dsalunga/KS5-Project/diagrams/start.jpg

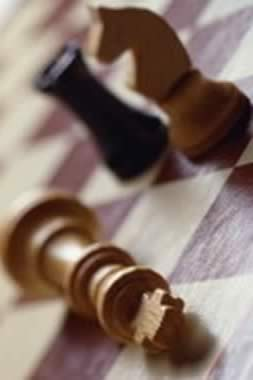
diagrams/start.jpg
