dsalunga/KS5-Project/README.md

# KS5 Project
B. S. Computer Engineering Thesis (Design Project)
