dsalunga/KS5-Project/docs/Chapter VI.pdf

Chapter VI

Conclusion and Recommendations

Conclusion

Given only less than three months and occurrence of inevitable problems

in hardware design, some of the scopes of the study were not realized by the

proponents particularly on the software part. These concerns validation of

moves and capturing chess pieces. Some features such as K-S5’s ability to

accept inputs through Speech Recognition (Voice Command) and K-S5’s ability

to interact with the user through Speech Synthesis were also not realized.

Nevertheless, the proponents concluded that K-S5 can contribute in the

development of human-machine interaction. Because of the accuracy,

consistency and reliability of the machine, the concepts and theories covered by

the study can be adopted or implemented to other applications beneficial to the

different field of the industry. Having the stability and reliability of modern

application platform and programming languages, the functionality of hardware

components are fully maximize.

Recommendations

Due to the limited financial resources, time constraints and experimental

designs failures, the proponents failed to include certain features and

components to make the project a complete success. If further studies are to be

conducted regarding the proponents’ study, the following are some recommendations that the proponents think will improve the performance of the

K-S5:

- Use larger permanent magnet for the chess pieces for easier piece

detection.

- Instead of using the InpOut32.dll to access the parallel port, it is better

develop a device driver for the machine using the Windows Driver

Development Kit.

- Use microcontrollers with more I/O ports and higher memory capacity to

simplify design so that only one microcontroller will be used to control all

the actuators.

- Use better, more uniform chess pieces for weight and height consistency

and proper handling of the machine.

- Include other features such as the ability to accept inputs through Speech

Recognition (Voice Command) and ability to interact with the user through

Speech Synthesis.

- Improve the software part of the K-S5 to fully optimize the validation of

moves and capturing chess pieces.

Bibliography

1. Open Collector Outputs. Acroname. http://www.acroname.com
2. Baker B.C. and Microchip Technology Inc. Circuit Layout Techniques and Tips. http://www.microchip .com/.
3. Boulé M.and Zilic Z. An FPGA Based Move Generator for the Game of Chess. McGill University, Montréal, Canada.
4. Brooks R.A. and Stein L.A. Building Brains for Bodies. Massachusetts Institute of Technology, Artificial Intelligence Laboratory, 545 Technology Square, Cambridge, MA 02139 USA.
5. Brooks R.A. (1990). Elephants Don’t Play Chess. MIT Artificial Intelligence Laboratory, Cambridge, MA 02139, USA.
6. Brooks R.A.(1991).Intelligence without Presentation. MIT Artificial Intelligence Laboratory, 545 Technology Square, Rm. 836, Cambridge, MA 02139.
7. Brooks R.A.. New Approaches to Robotics. Artificial Intelligence Laboratory, Massachusetts Institute of Technology, Cambridge, MA 02139
8. Boulé M.and Zilic Z. An FPGA Based Move Generator for the Game of Chess. McGill University, Montréal, Canada.
9. Buldyzhov V. and Brezhnev K. (2000). Chess Robot KG-2000. Ukrainian State Maritime University (USMTU).
10. Calvin W.H. (1997, May). The Chess Mentality. University of Washington.
11. Davis L. (1998-2005). Logic Threshold Voltage Levels.
12. Dickinson R. and Milano S. (2002, July). Isolated Open Loop Current Sensing Using Hall Effect Technology in an Optimized Magnetic Circuit. Allegro MicroSystems, Inc.
13. Gingrich D. (1999, July). RL Circuit. http://www.phys.ualberta.ca/~gingrich/.

14. Hewis J. (2005). Transistor Circuits. Electronics Club, Kelsey Park School. http://www.kpsec.freeuk.com/.
15. WABOT (200-2004). Humanoid Robotics Institute, Waseda University. http://www.humanoid.rise.waseda.ac.jp/.
16. Deep Blue (1997). IBM Research. http://www.research.ibm.com/deepblue/.
17. Jones, D. W. (1995). Control of Stepping Motors. The University Of IOWA Department Of Computer Science, http://www.cs.uiowa.edu/~jones/.
18. Laidman R. (2001). Stepper Motors and Control: Part IV -Microstepping of Stepper Motors.
19. Mann T. (2003). Chess Engine Communication Protocol. http://www.tim-mann.org/.
20. Microsoft Encarta Encyclopedia 2003 (1992-2002). Microsoft Corporation
21. MSDN Library 2004 (1987-2004). Microsoft Corporation
22. Wabot-2 and Inventor. MSN Encarta. http://encarta.msn.com/.
23. Peacock, C. (1998, February). Interfacing the Standard Parallel Port. http://www.senet.com.au/~cpeacock/.
24. Ryan V. (2002). Light Dependent Resistors. http://www.technologystudent.com/elec1/.
25. Simpson M. (2001-1004). Interface to a 74HC165 Shift Register. Kronos Robotics.
26. Stallings W. (2004). The Complexity of Algorithms.
27. Stork D.G. (1997). HAL, Deep Blue and Kasparov. http://www.research.ibm.com/deepblue/.
28. Bakukang UP MOBOT (2004). UP Department of Electrical & Electronics Engineering Mobile Robotics Laboratory. http://www.upd.edu.ph/~mobot lab/.
