dsalunga/KS5-Project/docs/appendices/diagrams.pdf

Appendix D
Main Circuit PCB Layout

Appendix H
Main Board Sensor-A PCB Layout

Appendix J
Side Board Sensor PCB Layout

Appendix I
Main Board Sensor-B PCB Layout

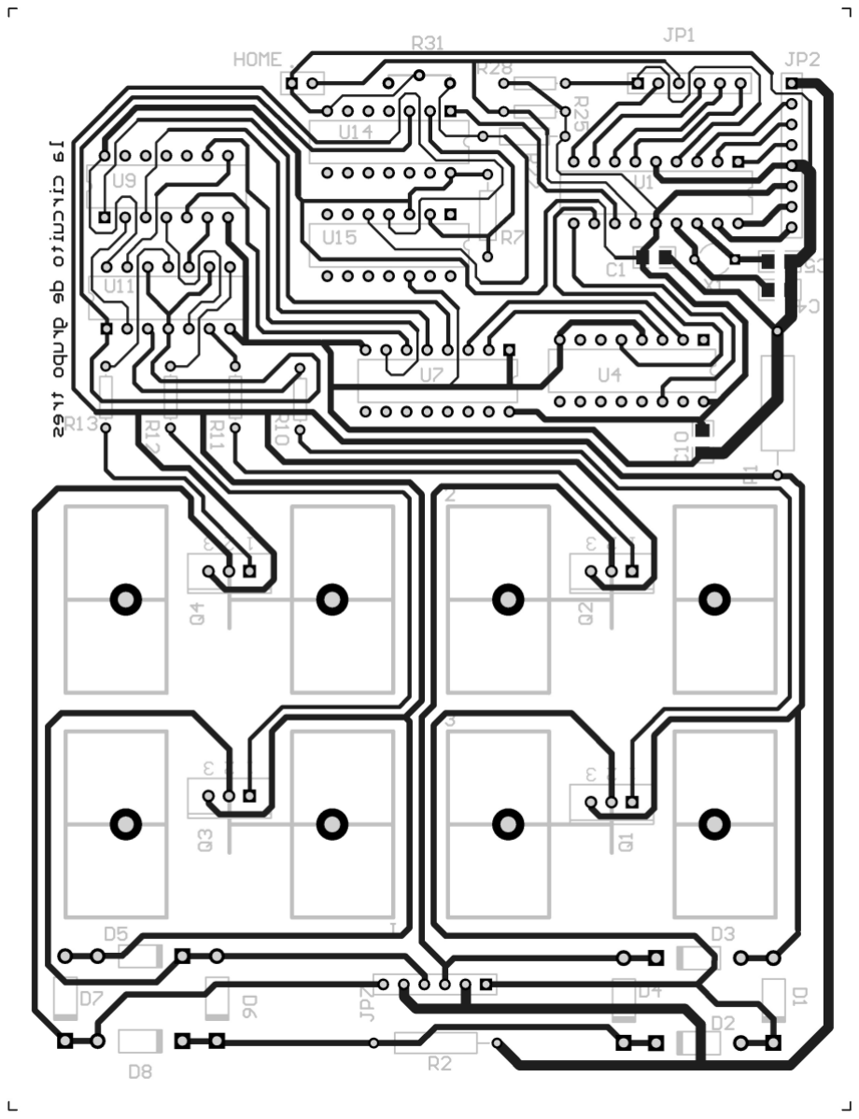
[picture p17: figure]

Appendix E

X-Axis Controller PCB Layout

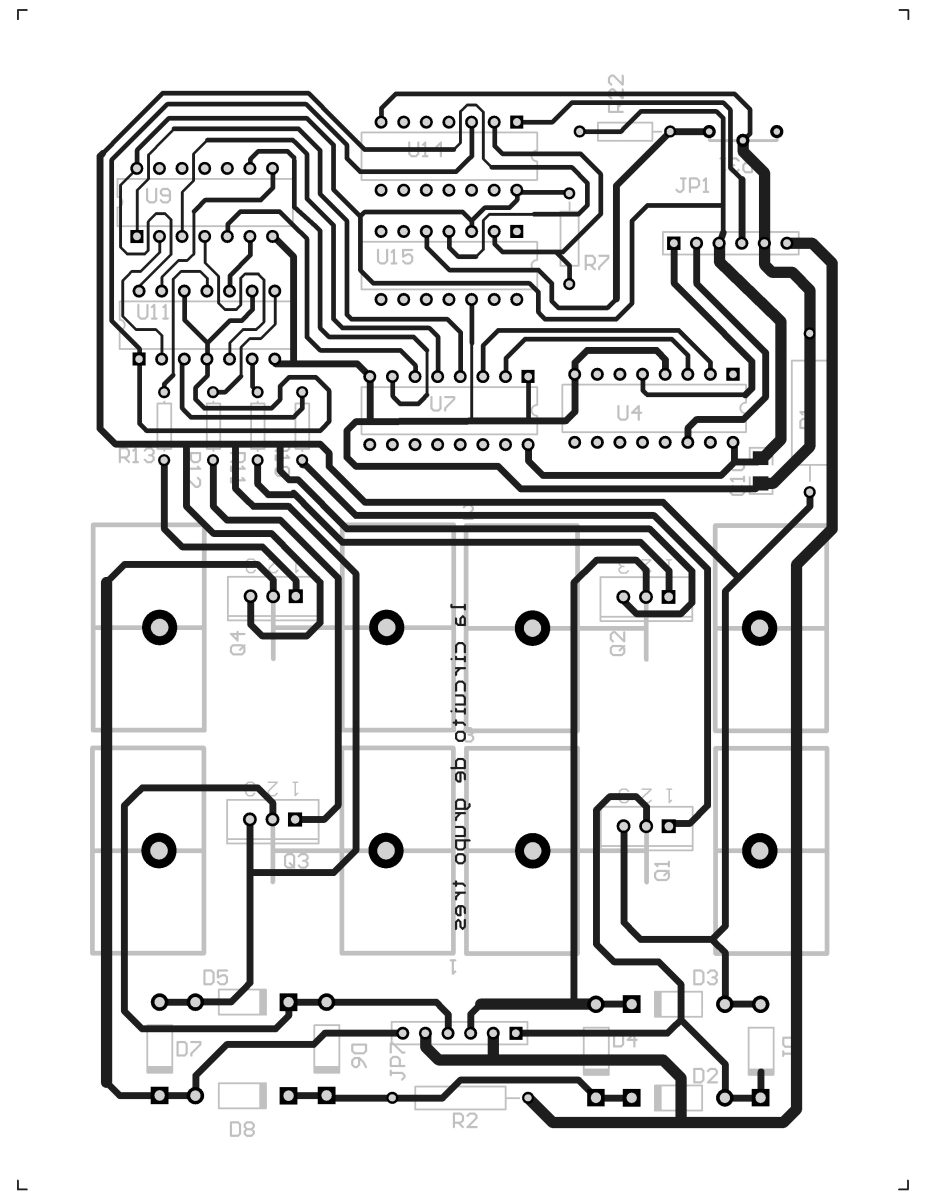
[picture p18: figure]

Appendix F

Y-Axis Controller PCB Layout

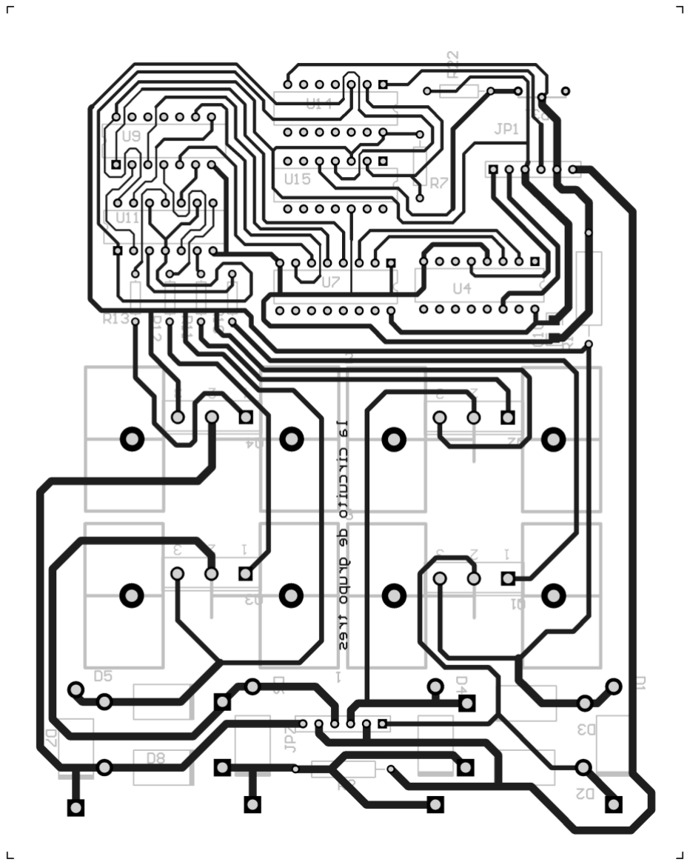
[picture p19: figure]

Appendix G

Z-Axis Controller PCB Layout
