dsalunga/KS5-Project/docs/appendices/screenshot.pdf

Appendix K
KS5.KS5Console.exe Screenshot

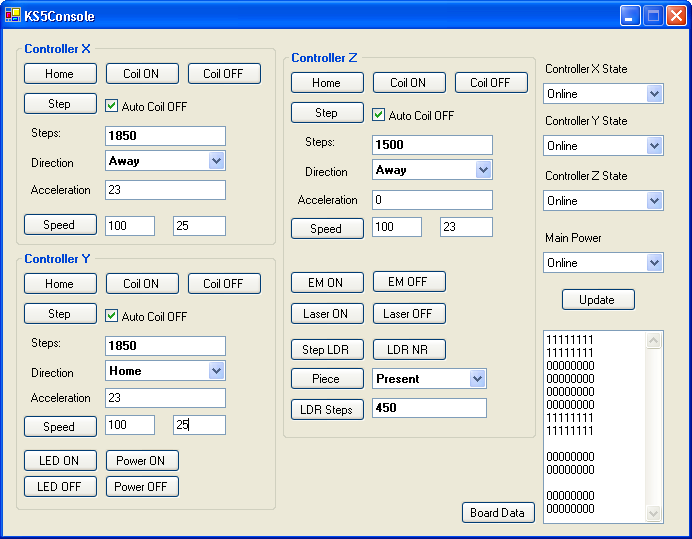
[picture p20: figure]

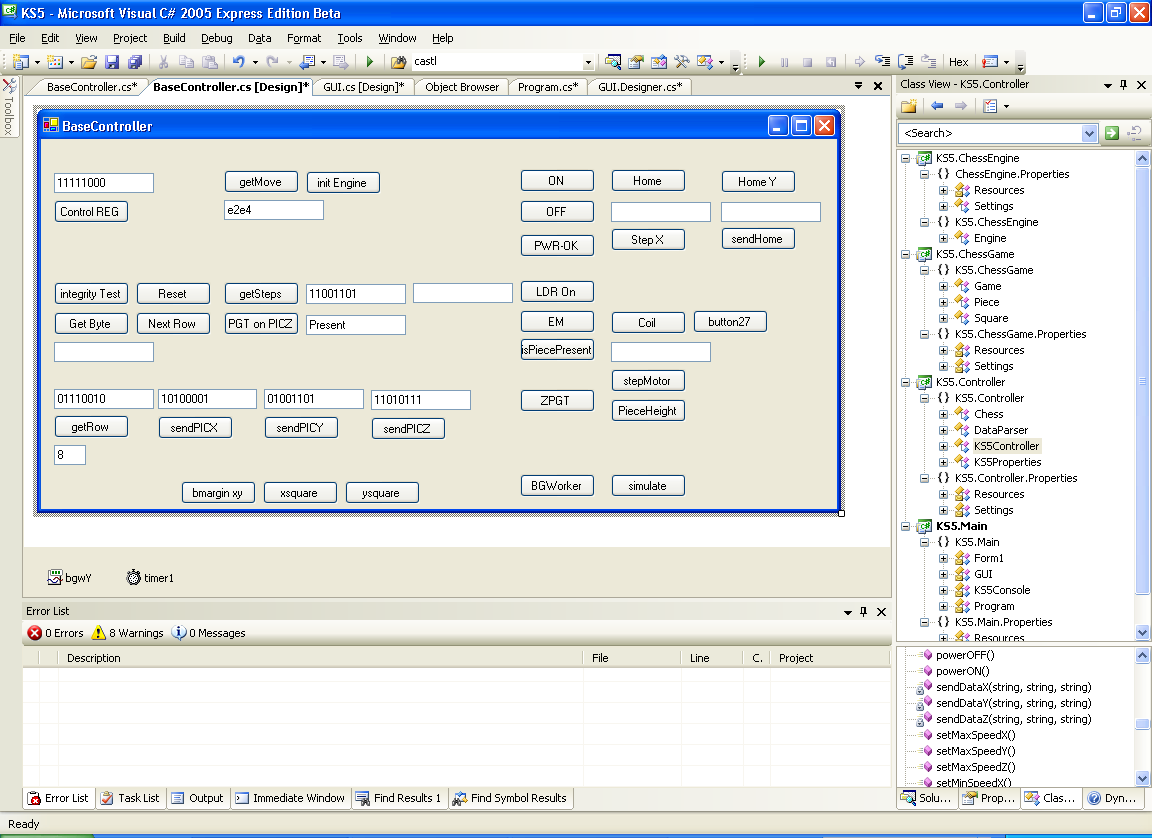
[picture p21: figure]

Appendix L

KS5.BaseController.exe Screenshot

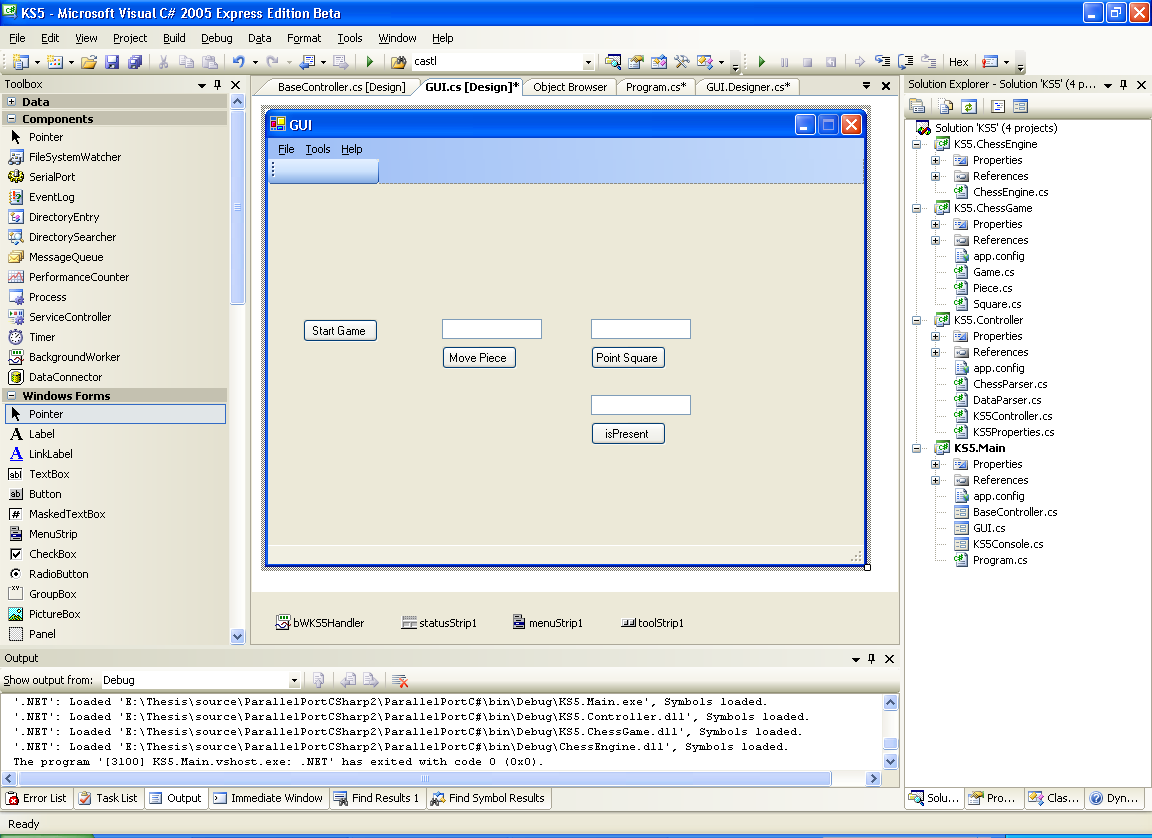
[picture p22: figure]

Appendix M

KS5.GUI.exe Screenshot
