dsalunga/KS5-Project/diagrams/D--Thesis-Conceptual Framework.tif

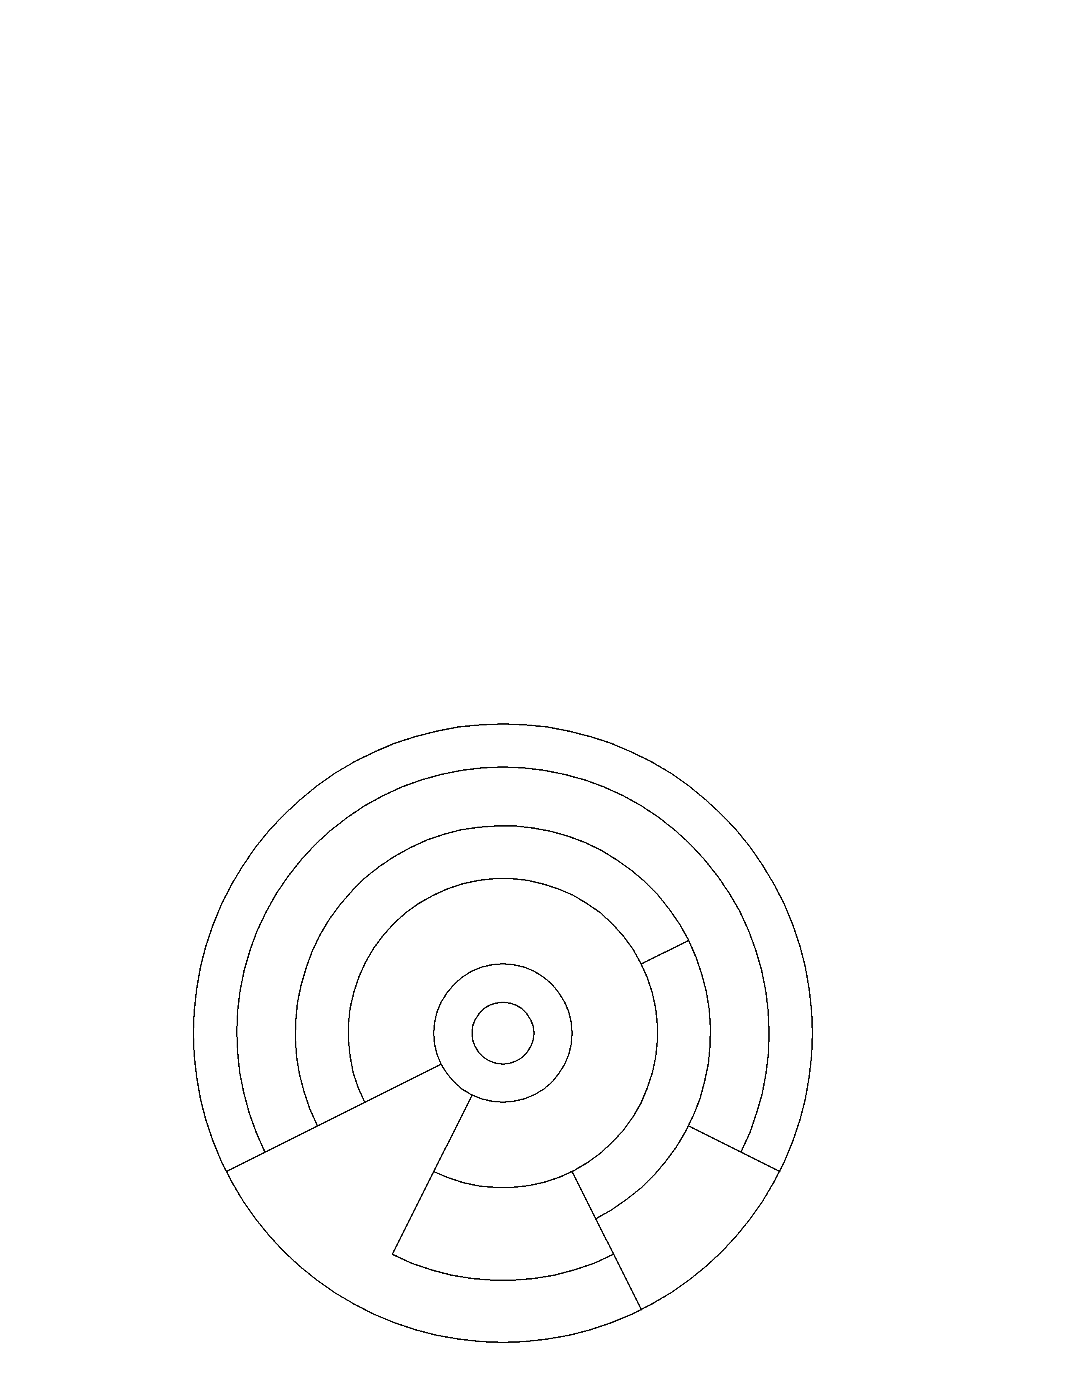
diagrams/D--Thesis-Conceptual Framework.tif
