dsalunga/KS5-Project/diagrams/l_blau.gif

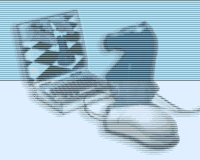
diagrams/l_blau.gif
