dsalunga/KS5-Project/diagrams/overview.jpg

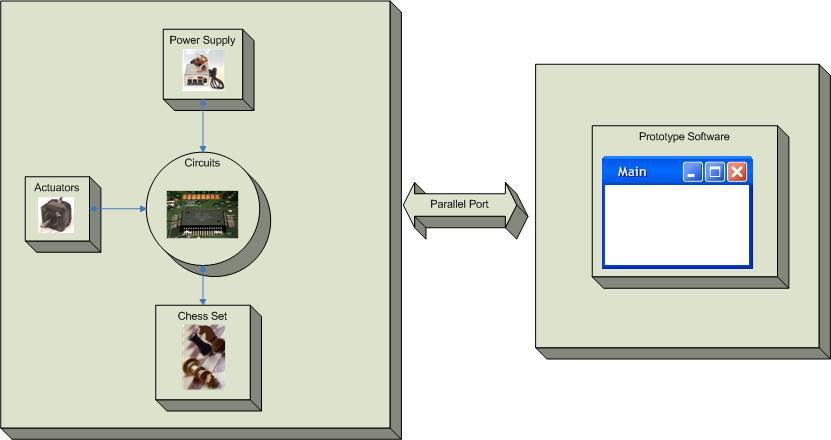
diagrams/overview.jpg
