dsalunga/KS5-Project/diagrams/Thesis-Conceptual Framework.JPG

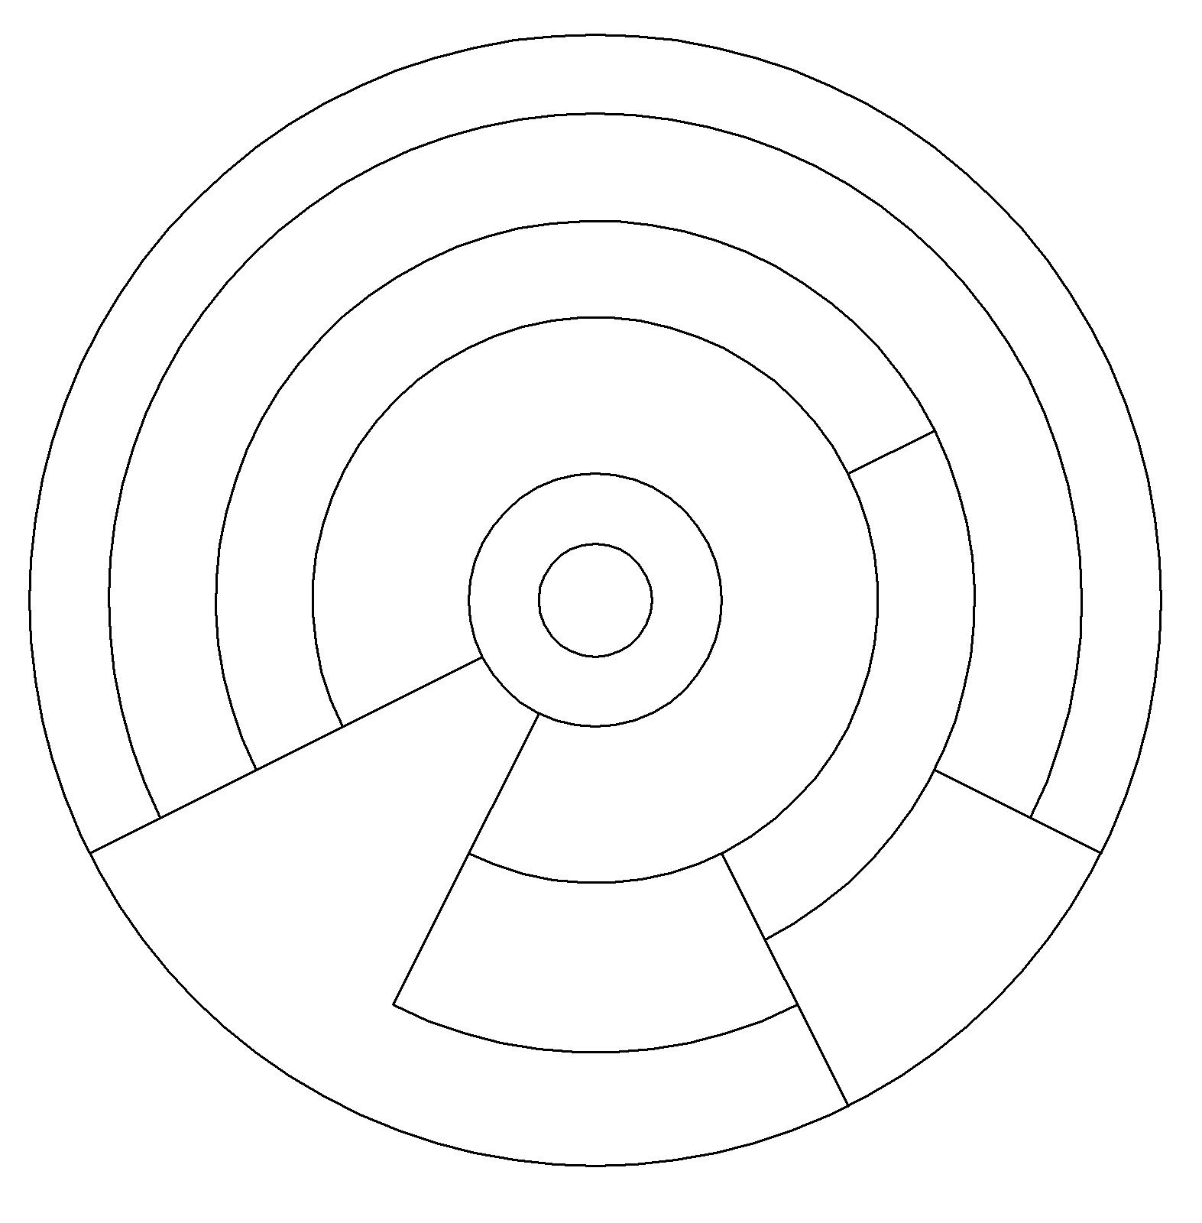
diagrams/Thesis-Conceptual Framework.JPG
