dsalunga/KS5-Project/PIC16F84A/NOPP/NOPPP2.TIF

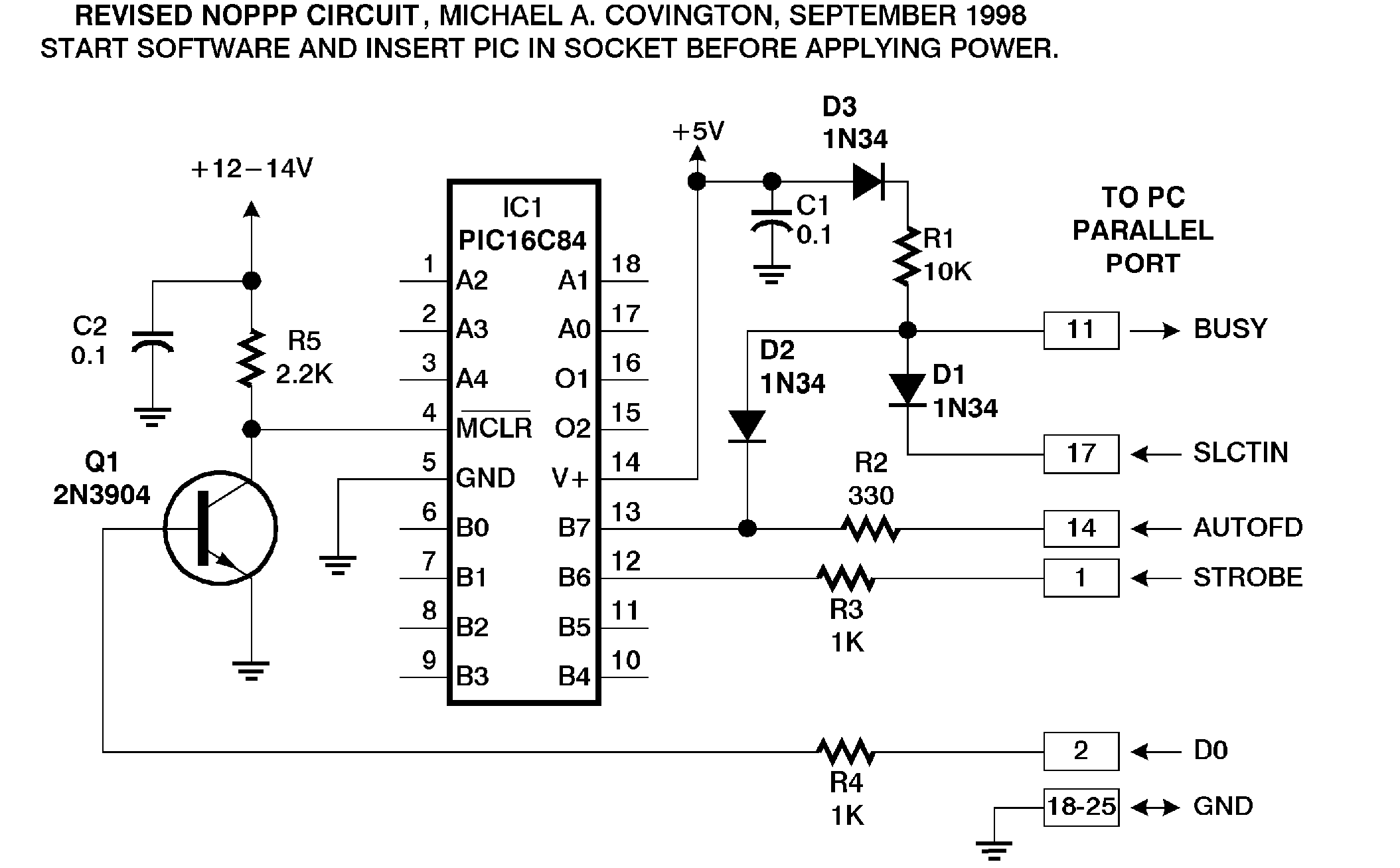
PIC16F84A/NOPP/NOPPP2.TIF
