dsalunga/KS5-Project/PIC16F84A/NOPP/NOPPPF4S.TIF

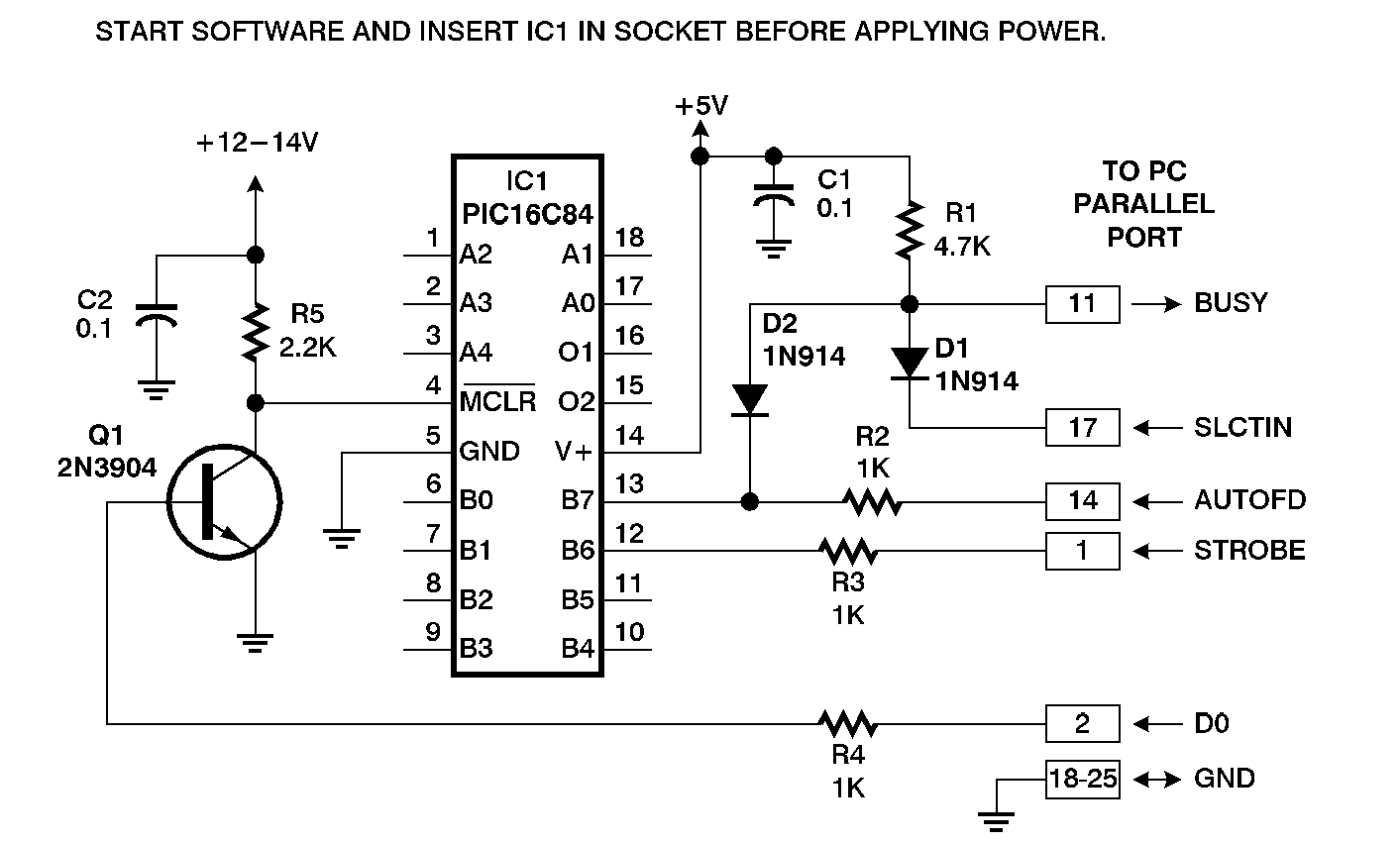
PIC16F84A/NOPP/NOPPPF4S.TIF
