dsalunga/KS5-Project/(list of files, cad)

Other CAD files:
diagrams/actual layout.dwg
diagrams/PCB/pcb - final2.dwg
diagrams/Schematic/schematic.dwg
diagrams/Conceptual Framework.dwg
diagrams/PCB/pcb.dwg
diagrams/burner - pcb.dwg
diagrams/PCB/pcb - final.dwg
diagrams/boardlayout.dwg
diagrams/PCB/pcb - final3.dwg
diagrams/HALL GUIDE.dwg
diagrams/board.dwg
diagrams/ppg.dwg
