dsalunga/KS5-Project/docs/appendices/schematics.pdf

# Appendix C Sensor Board Circuit Schematic Diagram

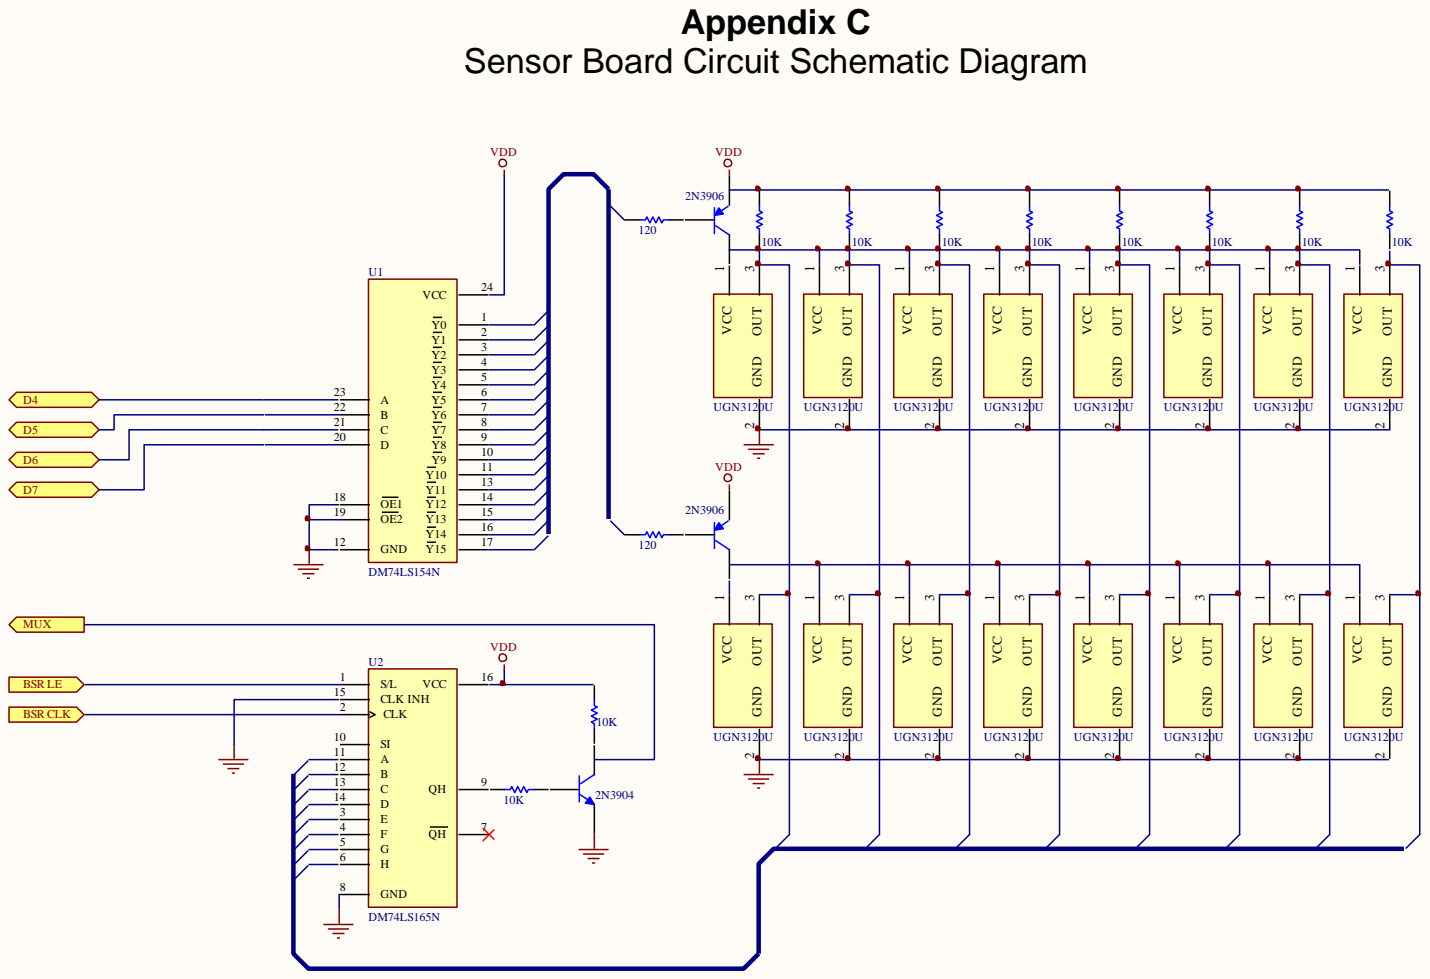
[picture p29: page 1]
GND 12; VCC; 2N3906 VCC 1 GND; 2 OUT; UGN3120U; 1 GND; S/L 1 CLK INH 15 CLK 2; GND 8; BSR LE; MUX; BSR CLK; VDD

# Appendix B Driving Circuit Schematic Diagram

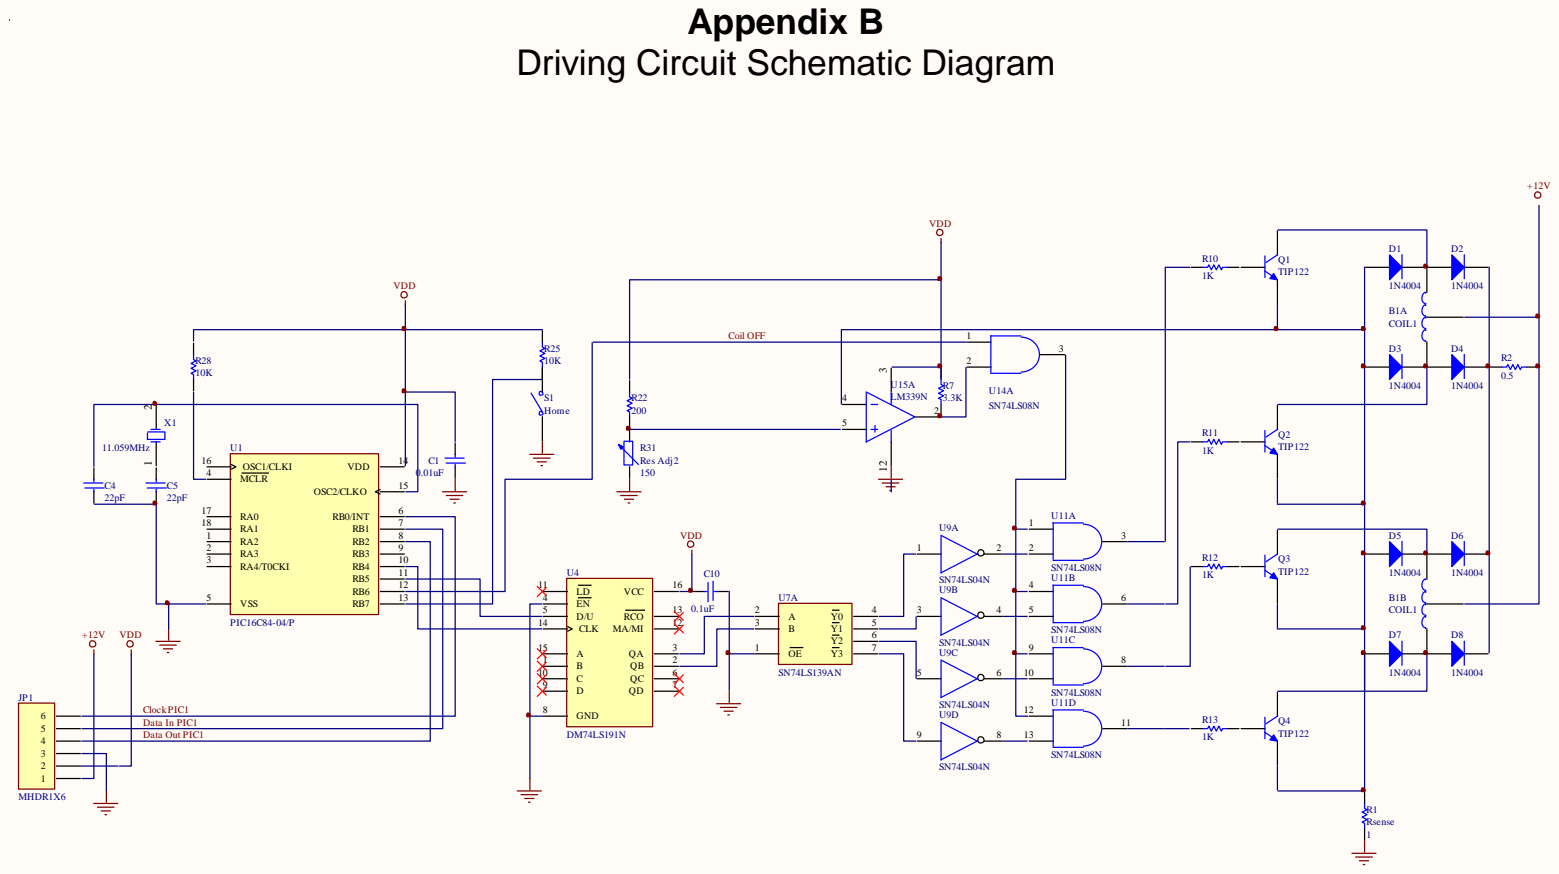
[picture p30: page 2]

# Appendix A Main Circuit Schematic Diagram

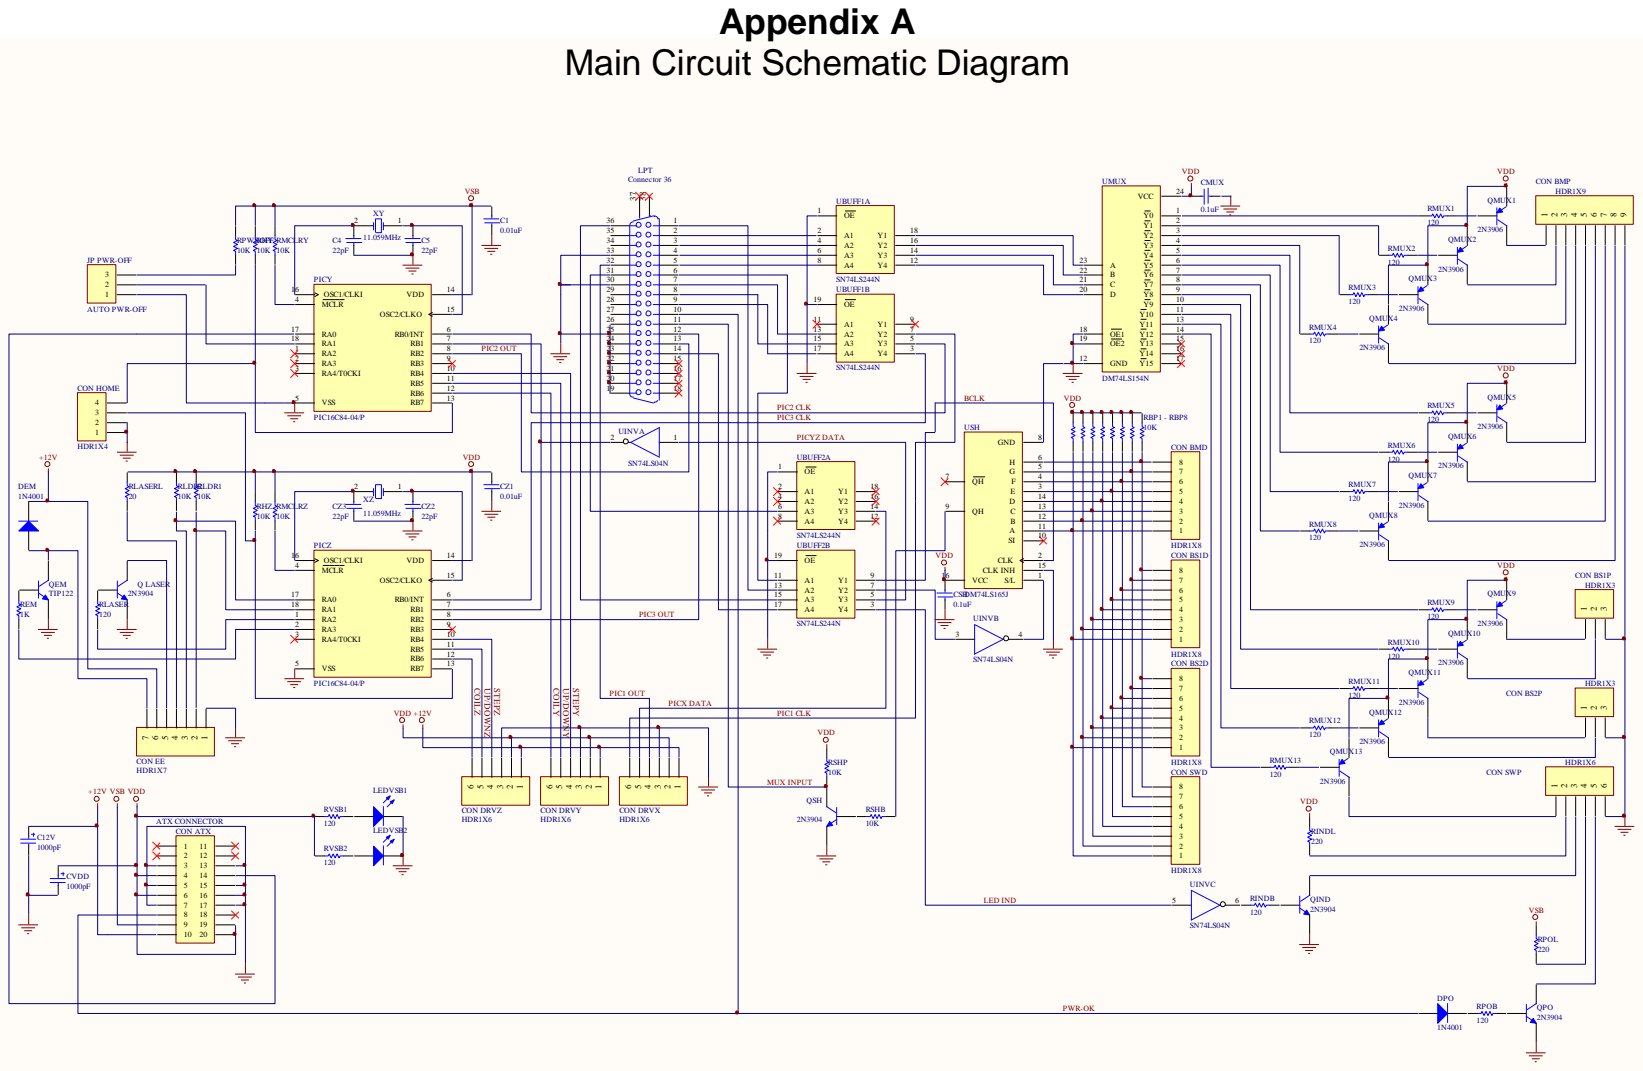
[picture p31: page 3]
UBUFF1A; UBUFF1B; QMUX1; QMUX2; VDD; QIND; Q LASER; TIP122; QEM; DEM; RA0 17 RA1 18 RA2 1 RA3 2 RA4/T0CKI 3; RB0/INT; 13 VSS 5; MCLR 4; OSC1/CLKI 16; OSC2/CLKO; PIC16C84-04/P; PICY; VSB; 11.059MHz; PIC1 OUT; PIC2 OUT; HDR1X6; CON DRVY; CON DRVX; VDD +12V; Connector 36; LPT; BCLK; PIC1 CLK; PIC2 CLK; CON DRVZ; PIC3 OUT; PICYZ DATA; MUX INPUT; QPO; DPO; HDR1X8; CON BMD; CON BS2D; CON BS1D; CON SWD; QMUX3; QMUX4; HDR1X9; CON BMP; QMUX5; QMUX6; QMUX7; QMUX8; QMUX9; QMUX10; QMUX11; QMUX12; HDR1X3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

JP PWR-OFF

AUTO PWR-OFF

2 UINVA SN74LS04N | 1

PIC3 CLK

VDD COILY UP/DOWNY STEPY
