dsalunga/KS5-Project/(list of files, drawings)

Other design files:
diagrams/main/LPTCON.PCBDOC
diagrams/main/PCB1.PcbDoc
diagrams/main/PCB1[1].PcbDoc
diagrams/main/PCB1[2].PcbDoc
diagrams/main/PCB Project1.PrjPCB
diagrams/main/PcbLib1.PcbLib
diagrams/Schematic/boardsensor/Documents/adua.PcbDoc
diagrams/Schematic/boardsensor/Documents/Board Sensor2.PcbDoc
diagrams/Schematic/boardsensor/Documents/Board Sensor - extra.PcbDoc
diagrams/Schematic/boardsensor/Documents/Board Sensor - Part2.PcbDoc
diagrams/Schematic/boardsensor/Documents/Board Sensor.PcbDoc
diagrams/Schematic/boardsensor/Documents/Documents.PRJPCB
diagrams/Schematic/boardsensor/Documents/Driver2.PcbDoc
diagrams/Schematic/boardsensor/Documents/driver2.SchDoc
diagrams/Schematic/boardsensor/Documents/Driver3.PcbDoc
diagrams/Schematic/boardsensor/Documents/Driver3.SchDoc
diagrams/Schematic/boardsensor/Documents/Driver4.PcbDoc
diagrams/Schematic/boardsensor/Documents/Driver5.PcbDoc
diagrams/Schematic/boardsensor/Documents/Driver.PcbDoc
diagrams/Schematic/boardsensor/Documents/END EFFECTOR.SchDoc
diagrams/Schematic/boardsensor/Documents/Library.SchLib
diagrams/Schematic/boardsensor/Documents/MAIN2.SchDoc
diagrams/Schematic/boardsensor/Documents/main.PCBDOC
diagrams/Schematic/boardsensor/Documents/MAIN.SchDoc
diagrams/Schematic/boardsensor/Documents/PCB1.PcbDoc
diagrams/Schematic/boardsensor/Documents/PcbLib1.PcbLib
diagrams/Schematic/boardsensor/Documents/Picker.PcbDoc
diagrams/Schematic/boardsensor/Documents/Sheet1.SchDoc
